Kaveesha229/KDU-MSD-Line-following-robot-with-pick-and-place-using-color-sensor-and-image-processing/IMG_0137.jpg

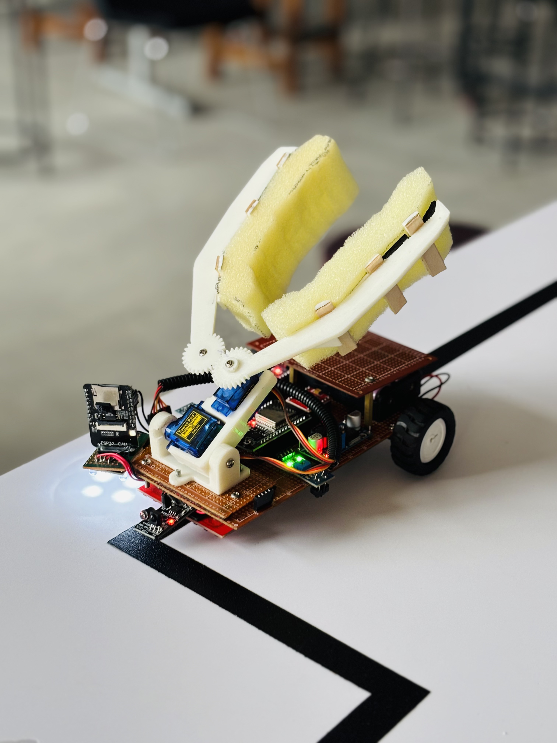
IMG_0137.jpg
