Kaveesha229/KDU-MSD-Line-following-robot-with-pick-and-place-using-color-sensor-and-image-processing/MSD/final MSD/final/to left/to left object/to_left_object/to_left_object.ino

#define THRESHOLD 3800

#define BLYNK_TEMPLATE_ID "TMPL6u1INiQJK"
#define BLYNK_TEMPLATE_NAME "testing"
#define BLYNK_AUTH_TOKEN  "A9WRT8HhAkMjEPaqgRhP1J1uALbEtV6G"

#include <WiFi.h>
#include <BlynkSimpleEsp32.h>

char auth[] = BLYNK_AUTH_TOKEN;
const char* ssid = "iPhone 15";
const char* password = "1234567890";

#define IR1 14
#define IR2 27
#define IR3 26
#define IR4 25
#define IR5 33
#define IR6 32
#define IR7 35
#define IR8 34
#define IRL 4
#define IRR 2
#define IRF 13

#define LMotorA 19
#define LMotorB 21
#define LMotorPWM 22

#define RMotorA 5
#define RMotorB 18
#define RMotorPWM 23

#define MAX_SPEED 150
#define turn_speed 150

int MotorBasespeed = 110;

int IR_VAL[8] = {0, 0, 0, 0, 0, 0, 0, 0};
int IR_weights[8] = { -30, -20, -10, -5, 5, 10, 20, 30};
int IR_PINS[8] = {IR1, IR2, IR3, IR4, IR5, IR6, IR7, IR8};

int start[3];
int finish[3];
int blynk[2] = {0, 0}; // RED = 1 , GREEN = 2 , BLUE = 3
int colorCount = 0;
int color;
int blynk_count = 0;

int startIndex = 0;
int finishIndex = 0;

int RMOTORSpeed = 0;
int LMOTORSpeed = 0;
int speedAdjust = 0;

float P, I, D;
float error = 0;
float previousError = 0;
float Kp = 0.5;
float Kd = 0.1;
float Ki = 0;

int IRR_value;
int IRL_value;
int distance_obj;

int line = 90;
int whi = 450;

void PID_control();
void read_IR();
void set_speed();
void set_forward();
void set_backward();
void stop();
void break_s();
void RL();
void turnright();
void turnleft();
void turn180();
void objectdetect();
void linefollowing(int baseSpeed);
void IR_value();
void toright();
void toleft();
void detect_color();
void turn180right();
void kola_pata();
void nil_pata();
void do_colorsen();
void undo_colorsen();
void turn180left();
void nil_patap();
void kola_patap();
void place_2();
void place_3();
void place_4();
void place_5();
void sleft();
void sright();

const int OFFSET_MM = 30;

int b = 578;
int k;

void setup() {
  Serial.begin(115200);
  Serial2.begin(9600, SERIAL_8N1, 16, 17);

  WiFi.begin(ssid, password);
  Blynk.begin(auth, ssid, password);

  pinMode(IR1, INPUT);
  pinMode(IR2, INPUT);
  pinMode(IR3, INPUT);
  pinMode(IR4, INPUT);
  pinMode(IR5, INPUT);
  pinMode(IR6, INPUT);
  pinMode(IR7, INPUT);
  pinMode(IR8, INPUT);

  pinMode(RMotorA, OUTPUT);
  pinMode(RMotorB, OUTPUT);
  pinMode(RMotorPWM, OUTPUT);
  pinMode(LMotorA, OUTPUT);
  pinMode(LMotorB, OUTPUT);
  pinMode(LMotorPWM, OUTPUT);

  pinMode(IRR, INPUT);
  pinMode(IRL, INPUT);
  pinMode(IRF, INPUT);

  set_forward();
  delay(2000);
}

void loop() {

  if (b == 578) {
    Blynk.run();
    Serial.println(blynk[0]);
    Serial.println(blynk[1]);
    if (blynk_count == 6) {
      b = 579;
    }
  }

  if (b == 579) {
    WiFi.mode(WIFI_OFF);
    break_s();
    delay(3000);
    b = 560;
  }

  if (b == 560) {
    set_forward();
    delay(100);
    b = 561;
  }

  if (b == 561) {
    unsigned long startTime = millis();
    while (millis() - startTime < 300) {
      linefollowing(line);
    }
    b = 1;
  }

  if (b == 1) {
    Serial2.println('1');
    delay(1000);
    Serial.println("Current section: b = 1");
    b = 2;
  }

  if (b == 2) {
    Serial.println("Current section: b = 2");
    toright();
    b = 3;
  }

  if (b == 3) {
    Serial.println("Current section: b = 3");
    toleft();
    b = 4;
  }

  if (b == 4) {
    Serial.println("Current section: b = 4");
    linefollowing(70);
    objectdetect();
    if (distance_obj == 1) {
      break_s();
      delay(3000);
      linefollowing(line);
      b = 6;
    }
  }

  if (b == 6) {
    Serial.println("Current section: b = 6");

    if (start[0] == blynk[1]) {

      place_2();

      b = 7;
    } else {
      b = 18;
    }
  }

  if (b == 7) {
    Serial.println("Current section: b = 7");
    turn180right();
    linefollowing(line);
    b = 8;
  }

  if (b == 8) {
    Serial.println("Current section: b = 8");
    if (start[1] == blynk[0]) {
      b = 9;
    } else {
      b = 12;
    }
  }

  if (b == 9) {
    Serial.println("Current section: b = 9");

    place_3();

    b = 10;
  }

  if (b == 10) {
    Serial.println("Current section: b = 10");
    turn180();
    b = 1100;
  }

  if (b == 1100) {
    linefollowing(line);
    IRL_value = digitalRead(IRL);
    if (IRL_value == 1) {
      b = 1101;
    }
  }

  if ( b == 1101) {
    unsigned long startTime = millis();
    while (millis() - startTime < whi) {
      linefollowing(line);
    }
    b = 11;
  }

  if (b == 11) {
    b = 100;
  }

  if (b == 12) {
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
    linefollowing(110);
    IRL_value = digitalRead(IRL);
    if (IRL_value == 1) {
      b = 245;
    }
  }

  if (b == 245) {
    unsigned long startTime = millis();
    while (millis() - startTime < whi) {
      linefollowing(line);
    }
    b = 246;
  }

  if (b == 246) {
    b = 300;
  }

  if (b == 248) {
    linefollowing(110);
    IRL_value = digitalRead(IRL);
    if (IRL_value == 1) {
      break_s();
      delay(300);
      b = 249;
    }
  }

  if (b == 249) {
    unsigned long startTime = millis();
    while (millis() - startTime < whi) {
      linefollowing(line);
    }
    b = 250;
  }

  if (b == 250) {
    toright();
    b = 251;
  }

  if (b == 251) {
    unsigned long startTime = millis();
    while (millis() - startTime < 700) {
      linefollowing(line);
      b = 252;
    }
    break_s();
    delay(3000);
  }


  if (b == 252) {
    kola_patap();
  }

  if (b == 300) {
    break_s();
    delay(3000);
    b = 301;
  }

  if (b == 301) {
    toleft();
    b = 302;
  }

  if (b == 302) {
    toleft();
    b = 303;
  }

  if (b == 303) {
    linefollowing(line);
    IRL_value = digitalRead(IRL);
    if (IRL_value == 1) {
      b = 304;
    }
  }

  if (b == 304) {
    unsigned long startTime = millis();
    while (millis() - startTime < 550) {
      linefollowing(110);
    }
    b = 305;

  }

  if (b == 305) {
    break_s();
  }
}

void PID_control() {
  error = 0;
  for (int i = 0; i < 8; i++) {
    error += IR_weights[i] * IR_VAL[i];
  }
  P = error;
  I = I + error;
  D = error - previousError;
  previousError = error;

  speedAdjust = (Kp * P + Ki * I + Kd * D);

  RMOTORSpeed = MotorBasespeed - speedAdjust;
  LMOTORSpeed = MotorBasespeed + speedAdjust - 6.5;

  RMOTORSpeed = constrain(RMOTORSpeed, 0, MAX_SPEED);
  LMOTORSpeed = constrain(LMOTORSpeed, 0, MAX_SPEED);
}

void read_IR() {
  for (int i = 0; i < 8; i++) {
    int analogValue = analogRead(IR_PINS[i]);
    IR_VAL[i] = (analogValue > THRESHOLD) ? 1 : 0;
  }
}

void IR_value() {
  IRR_value = digitalRead(IRR);
  Serial.println(IRR_value);
  IRL_value = digitalRead(IRL);
  Serial.println(IRL_value);
}

void objectdetect() {
  int irf_val = digitalRead(IRF);
  if (irf_val == HIGH) {
    distance_obj = 0;
  } else {
    distance_obj = 1;
  }
}

void set_speed() {
  analogWrite(LMotorPWM, LMOTORSpeed);
  analogWrite(RMotorPWM, RMOTORSpeed);
}

void linefollowing(int baseSpeed) {
  MotorBasespeed = baseSpeed;
  set_forward();
  read_IR();
  PID_control();
  set_speed();
}

void turn180right() {
  Serial.println("turn180right");
  k = 1;
  if (k == 1) {
    linefollowing(line);
    turn180();
    k = 2;
  }
  if (k == 2 ) {
    toright();
    k = 3;
  }
  if (k == 3) {
    toright();
    k = 4;
  }

  if (k == 4) {
    int y = 1;
    while (y == 1) {
      Serial.println("vjjbhjbjh");
      linefollowing(70);
      objectdetect();
      if (distance_obj == 1) {
        break_s();
        delay(1000);
        y = 0;
      }
    }
  }
}

void turn180left() {
  Serial.println("turn180right");
  k = 1;
  if (k == 1) {
    turn180();
    k = 2;
  }

  if (k == 2 ) {
    toleft();
    k = 3;
  }
  if (k == 3) {
    toleft();
    k = 4;
  }

  if (k == 4) {
    unsigned long startTime = millis();
    while (millis() - startTime < 700) {
      linefollowing(line);
    }
    break_s();
    delay(3000);
  }
}

void kola_pata() {
  k = 1;
  if (k == 1) {

    place_3();

    k = 2;
  }

  if (k == 2) {
    linefollowing(line);
    turn180();
    k = 3;
  }

  if (k == 3) {
    toleft();
    k = 4;
  }

  if (k == 4) {
    toright();
    k = 5;
  }

  if (k == 5) {
    b = 100;
  }
}

void nil_pata() {
  k = 1;
  if (k == 1) {

    place_3();

    k = 2;
  }

  if (k == 2) {
    linefollowing(line);
    turn180();
    k = 3;
  }

  if (k == 3) {
    toright();
    k = 4;
  }

  if (k == 4) {
    toleft();
    k = 5;
  }

  if (k == 5) {
    b = 100;
  }
}

void nil_patap() {
  k = 1;
  if (k == 1) {

    place_5();

    k = 2;
  }

  if (k == 2) {
    turn180();
    k = 3;
  }

  if (k == 3) {
    toright();
    k = 4;
  }

  if (k == 4) {
    toleft();
    k = 5;
  }

  if (k == 5) {
    b = 300;
  }
}

void kola_patap() {
  k = 1;
  if (k == 1) {

    place_5();

    k = 2;
  }

  if (k == 2) {
    turn180();
    k = 3;
  }

  if (k == 3) {
    toleft();
    k = 4;
  }

  if (k == 4) {
    toright();
    k = 5;
  }

  if (k == 5) {
    b = 300;
  }
}

void place_2() {
  set_backward();
  delay(350);
  break_s();

  delay(1000);
  Serial2.println('2');
  delay(17000);

  set_forward();
  delay(550);
}

void place_3() {
  set_backward();
  delay(350);
  break_s();

  delay(1000);
  Serial2.println('3');
  delay(12000);

  set_forward();
  delay(550);

}

void place_4() {
  set_backward();
  delay(350);
  break_s();

  delay(1000);
  Serial2.println('4');
  delay(10000);

  set_forward();
  delay(350);
}

void place_5() {
  set_backward();
  delay(350);
  break_s();

  delay(1000);
  Serial2.println('5');
  delay(17000);

  set_forward();
  delay(350);
}

void toleft() {
  int y = 1;
  while (y == 1) {
    Serial.println("Current section: to left");
    linefollowing(line);
    IRL_value = digitalRead(IRL);
    if (IRL_value == 1) {
      unsigned long startTime = millis();
      while (millis() - startTime < 500) {
        linefollowing(line);
      }
      turnleft();
      y = 0;
      Serial.println("Current section: toright, turn left");
    }
  }
}

void toright() {
  int y = 1;
  while (y == 1) {
    Serial.println("Current section: to right");
    linefollowing(line);
    IRR_value = digitalRead(IRR);
    if (IRR_value == 1) {
      unsigned long startTime = millis();
      while (millis() - startTime < 500) {
        linefollowing(line);
      }
      turnright();
      y = 0;
      Serial.println("Current section: toright, turn right");
    }
  }
}

void turnright() {
  digitalWrite(RMotorA, LOW);
  digitalWrite(LMotorA, turn_speed);
  digitalWrite(RMotorB, turn_speed);
  digitalWrite(LMotorB, LOW);
  delay(710);
  stop();
  delay(200);
}

void turnleft() {
  digitalWrite(RMotorA, turn_speed);
  digitalWrite(LMotorA, LOW);
  digitalWrite(RMotorB, LOW);
  digitalWrite(LMotorB, turn_speed);
  delay(700);
  stop();
  delay(200);
}

void stop() {
  digitalWrite(RMotorA, LOW);
  digitalWrite(LMotorA, LOW);
  digitalWrite(RMotorB, LOW);
  digitalWrite(LMotorB, LOW);
}

void break_s() {
  stop();  // Same as stop
}

void set_forward() {
  digitalWrite(RMotorB, LOW);
  digitalWrite(LMotorB, LOW);
  digitalWrite(RMotorA, 90);
  digitalWrite(LMotorA, 100);
}

void set_backward() {
  digitalWrite(RMotorB, 90);
  digitalWrite(LMotorB, 100);
  digitalWrite(RMotorA, LOW);
  digitalWrite(LMotorA, LOW);
}

void turn180() {
  digitalWrite(RMotorB, turn_speed);
  digitalWrite(LMotorB, LOW);
  digitalWrite(RMotorA, LOW);
  digitalWrite(LMotorA, turn_speed);
  delay(1700);
  set_forward();
  delay(50);
}

void sleft() {
  digitalWrite(RMotorA, LOW);
  digitalWrite(LMotorA, turn_speed);
  digitalWrite(RMotorB, LOW);
  digitalWrite(LMotorB, LOW);
  delay(200);
  stop();
}



bool isColorAlreadyStored(int code) {
  return (blynk[0] == code || blynk[1] == code);
}


void handleColorPress(int colorCode) {
  if (colorCount < 2 && !isColorAlreadyStored(colorCode)) {
    blynk[colorCount] = colorCode;
    colorCount++;
  }
}

//Cube V3
BLYNK_WRITE(V3) {
  int value = param.asInt();
  if (value == 1) {
    handleColorPress(11);
  }
}

// Sphere V4
BLYNK_WRITE(V4) {
  int value = param.asInt();
  if (value == 1) {
    handleColorPress(12);
  }
}

// Cylinder  V5
BLYNK_WRITE(V5) {
  int value = param.asInt();
  if (value == 1) {
    handleColorPress(13);
  }
}

void addToStart(int value) {
  if (startIndex < 3) {
    start[startIndex++] = value;
    blynk_count++;
  }
}

void addToFinish(int value) {
  if (finishIndex < 3) {
    finish[finishIndex++] = value;
    blynk_count++;
  }
}

BLYNK_WRITE(V10) {
  if (param.asInt() == 1) addToStart(11);
}

BLYNK_WRITE(V11) {
  if (param.asInt() == 1) addToStart(12);
}

BLYNK_WRITE(V12) {
  if (param.asInt() == 1) addToStart(13);
}

BLYNK_WRITE(V13) {
  if (param.asInt() == 1) addToFinish(11);
}

BLYNK_WRITE(V14) {
  if (param.asInt() == 1) addToFinish(12);
}

BLYNK_WRITE(V15) {
  if (param.asInt() == 1) addToFinish(13);
}
